nihatran/Pikachu-Robot/Pikachu Robot/3D Print Files/Pikachu Main Body.stl

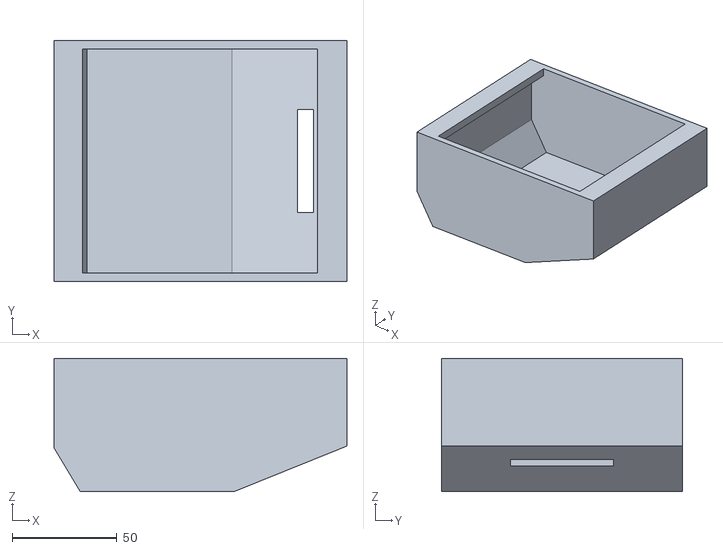
[picture p13: CAD file, 2023-05-08]
Pikachu Robot/3D Print Files/Pikachu Main Body.stl
139.6 x 115.0 x 63.5
