nihatran/Pikachu-Robot/Pikachu Robot/3D Print Files/Pikachu Base.stl

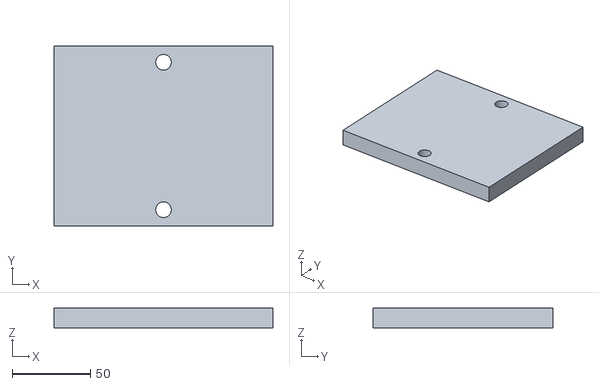
[picture p14: CAD file, 2023-05-08]
Pikachu Robot/3D Print Files/Pikachu Base.stl
139.6 x 115.0 x 12.7
