nihatran/Pikachu-Robot/Pikachu Robot/3D Print Files/Pikachu Ears Tail.stl

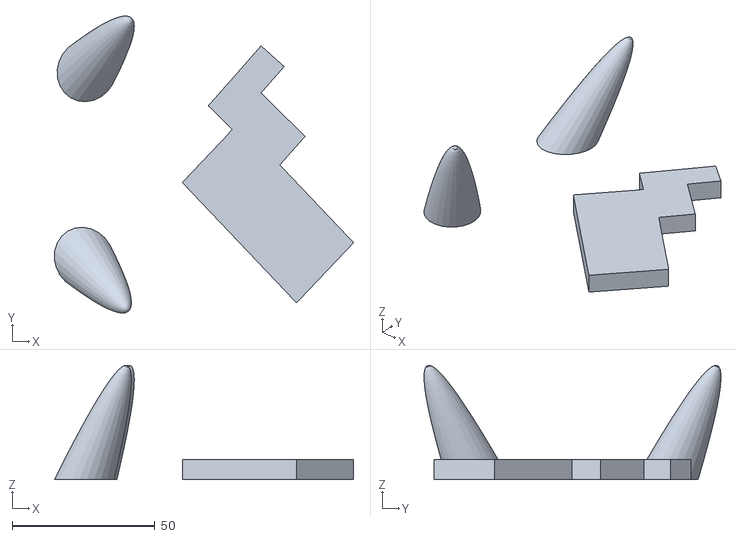
[picture p15: CAD file, 2023-05-08]
Pikachu Robot/3D Print Files/Pikachu Ears Tail.stl
104.8 x 104.0 x 40.0
